oclyke-retired/Doppler_LED_Controller/Hardware/Production/v2.0.1/ordering_instructions.txt

panel size, 117x126mm
PCB thickness, 1.6mm
number of layers, 2
soldermask color, Unknown
silkscreen color, White
oz copper, 1oz
finish, HASL lead free
stencils, bottom
pcs per panel, 2
