oclyke-retired/Doppler_LED_Controller/Hardware/Configuration/Pinout/DopplerPinout_v2.0.0.PNG

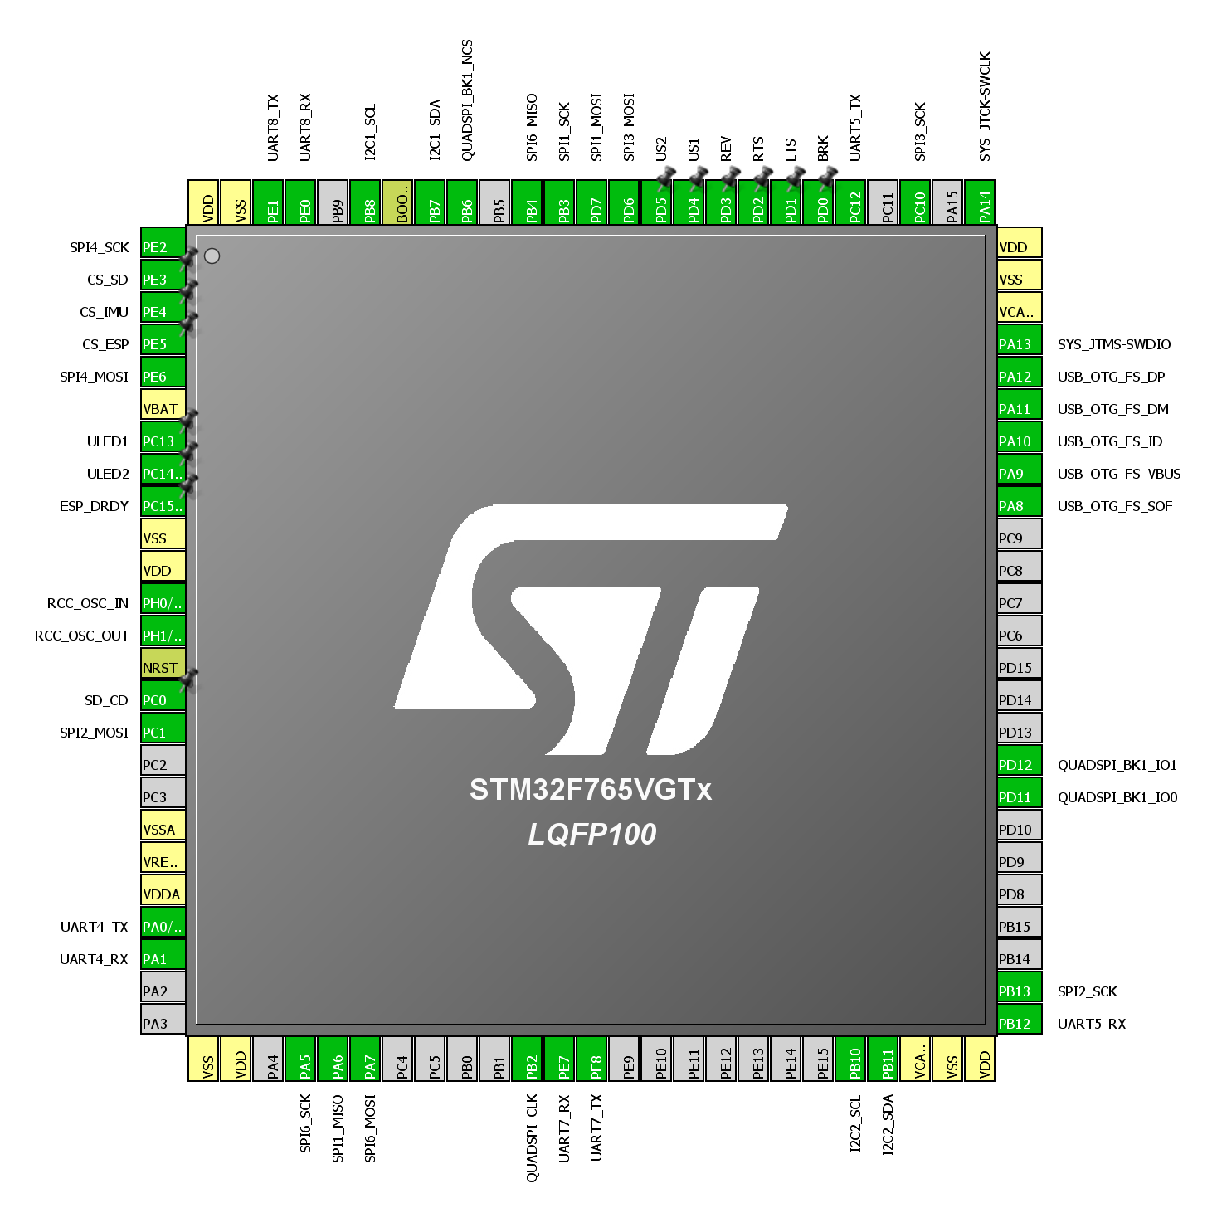
Hardware/Configuration/Pinout/DopplerPinout_v2.0.0.PNG
