oclyke-retired/Doppler_LED_Controller/Hardware/Doppler_LED_Controller.brd

## EAGLE design Hardware/Doppler_LED_Controller.brd (2018-11-28)

Schematic: Doppler_LED_Controller.sch

Parts:
C1, C3, C4, C6, C12, C13, C14, C15, C16, C20: 0.1uF; 0603
C2, C10, C11, C17, C18: 2.2uF; 0603
C5, C9: 10uF; 0603
C7, C8: 18pF; 0603
D1: ESPTX-GREEN; LED-0603
D2: ESP_STAT; APA102_2020_LONG
D3: ESPRX-YELLOW; LED-0603
D4: ULED1-BLUE; LED-0603
D5: ULED2-WHITE; LED-0603
D6: U7TX-GREEN; LED-0603
D8: U7RX-YELLOW; LED-0603
D10: 5.6V; SOD-323
D11: 3A/10V/280mV; SOD-323
D12: PWR-RED; LED-0603
F1: PPTC_6V500MA; 0805
FD1, FD2, FD3, FD4: FIDUCIAL1X2; FIDUCIAL-1X2
H1, H2, H3, H4: STAND-OFF
J1, J2: USB_MICRO-B_HALF_PTH_MILL; USB-MICROB-PTH-MILL
J3: CORTEX_DEBUG_PTH; 2X5-PTH-1.27MM
JP1: ALED1_VOUT_SEL; SMT-JUMPER_3_1-NC_TRACE_SILK
JP2: ALED2_VOUT_SEL; SMT-JUMPER_3_1-NC_TRACE_SILK
JP3: ALED3_VOUT_SEL; SMT-JUMPER_3_1-NC_TRACE_SILK
JP4: ALED4_VOUT_SEL; SMT-JUMPER_3_1-NC_TRACE_SILK
JP5, JP7: I2C1_VOUT_SEL; SMT-JUMPER_3_1-NC_TRACE_SILK
JP6: JUMPER-SMT_2_NO_SILK; SMT-JUMPER_2_NO_SILK
JP9: IMU_VSEL; SMT-JUMPER_3_1-NC_TRACE_SILK
JP10: MPU9250; SMT-JUMPER_2_NO_SILK
JP11: DEFUSE; SMT-JUMPER_2_NO_SILK
M1: EXT_SWTCH; 1X03_SMD_0.1IN
M2: EXT_SWTCH; 3_PIN_LOCK
M3: ALED1_LOCK; 3_PIN_LOCK
M4: ALED2_LOCK; 3_PIN_LOCK
M5: ALED3_LOCK; 3_PIN_LOCK
M6: ALED4_LOCK; 3_PIN_LOCK
M7: ALED1_SMD; 1X03_SMD_0.1IN
M8: ALED2_SMD; 1X03_SMD_0.1IN
M9: ALED3_SMD; 1X03_SMD_0.1IN
M10: ALED4_SMD; 1X03_SMD_0.1IN
M11: I2C1_LOCK; 4_PIN_LOCK
M13: U7_LOCK; 4_PIN_LOCK
M15: I2C1_SMD; 1X04_SMD_0.1IN
M17: U7_SMD; 1X04_SMD_0.1IN
M19: SIG_IN_LOCK; 4_PIN_LOCK
M20: SIG_IN_SMD; 1X04_SMD_0.1IN
M21: SD; SD_AMPHENOL_PUSH_PULL
M22: CONN_SMD_2; 1X02_SMD_0.1IN
M23: CONN_LOCK_2-5055670271; 2_PIN_LOCK
Q1: TRANS_NPN_DUAL-MBT3904DW1T1; SC70-6
Q2, Q3, Q4, Q5, Q6, Q7, Q8, Q9, Q10, Q12, Q14, Q16, Q18, Q19, Q20, Q21: AMP_MOSFET_NCH-2N7002K; SOT23-3
Q22, Q23: 4.3A/20V/54mΩ; SOT23-3
R1, R10: DNP; 0603
R3, R4, R6, R9, R16, R17, R18, R19, R20, R21, R22, R23, R24, R25, R26, R27, R28, R29, R30, R31, R32, R33, R34, R35, R36, R38, R39, R43, R47, R51, R57, R58, R59, R60, R61, R62, R63, R64, R65, R66, R67, R68: 10k; 0603
R7, R8, R11, R12, R53, R55, R69: 1k; 0603
R13, R14: 20; 0603
R37, R41, R45, R49: 2.2k; 0603
S1, S2, S3: US2; TACTILE_SWITCH_SMD_5.2MM
S4: STM_!RST; TACTILE_SWITCH_SMD_5.2MM
S5: US1; TACTILE_SWITCH_SMD_5.2MM
TP1: EDRDY; PAD.03X.04
TP3: ERX0; PAD.03X.04
TP4: ETX0; PAD.03X.04
TP5: E!RTS; PAD.03X.04
TP6: E!DTR; PAD.03X.04
TP7: EMOSI; PAD.03X.04
TP8: EMISO; PAD.03X.04
TP9: ESCLK; PAD.03X.04
TP10: ECS; PAD.03X.04
TP11: ESSI; PAD.03X.04
TP12: ESSCK; PAD.03X.04
TP13: E!RST; PAD.03X.04
TP17: VDDIO; PAD.03X.04
TP18: 1V8; PAD.03X.04
TP20: S1Si; PAD.03X.04
TP21: S1SO; PAD.03X.04
TP22: S1SCLk; PAD.03X.04
TP23: CSSD; PAD.03X.04
TP24: CSIMU; PAD.03X.04
TP25: SDCD; PAD.03X.04
TP29: CSIMUIO; PAD.03X.04
TP30: IMUINT; PAD.03X.04
TP31: IMUFS; PAD.03X.04
TP34: AL1D; PAD.03X.04
TP35: AL2D; PAD.03X.04
TP36: AL3D; PAD.03X.04
TP37: AL4D; PAD.03X.04
TP38: AL1V; PAD.03X.04
TP39: AL2V; PAD.03X.04
TP40: AL3V; PAD.03X.04
TP41: AL4V; PAD.03X.04
TP42: AL1C; PAD.03X.04
TP43: AL2C; PAD.03X.04
TP44: AL3C; PAD.03X.04
TP45: AL4C; PAD.03X.04
TP47: VRPP; PAD.03X.04
TP48: VOVP; PAD.03X.04
TP49: VUSB; PAD.03X.04
TP50: 5V; PAD.03X.04
TP51: 3V3; PAD.03X.04
TP52: GND; PAD.03X.04
TP53: IIC1SDA; PAD.03X.04
TP54: IIC1SCL; PAD.03X.04
TP57: U7TX; PAD.03X.04
TP58: U7RX; PAD.03X.04
TP62: STMR; PAD.03X.04
TP68: SWCLK; PAD.03X.04
TP69: BRK; PAD.03X.04
TP70: LTS; PAD.03X.04
TP71: RTS; PAD.03X.04
TP72: REV; PAD.03X.04
TP78: SWDIO; PAD.03X.04
U1: ESP-WROOM-32
U3: STM32F765VTG6; LQFP-100
U4: 1.8V; DDC5
U5: 9DoF IMU; QFN24-3X3
U6: TXB0108DQSR; UFDFN-20
U7: 3.3V; SOT23-5
U8: CH340C; SO016
U9: W25Q32FVSS; SOIC-8
U$98: REV_NUM
Y1: 24MHz; CRYSTAL-SMD-5X3.2-4PAD

Connections:
1.8V: JP9.3, TP18.P$1, U4.5 (VOUT)
3.3V: C2.1, C3.1, C4.1, C5.1, C6.1, C9.1, C14.1, C16.1, C18.1, C20.1, D1.A, D2.4VCC, D3.A, D4.A, D5.A, D6.A, D8.A, D12.A, J3.1 (VCC), JP1.1, JP2.1, JP3.1, JP4.1, JP5.3, JP6.1, JP7.3, JP9.1, M1.P$2 (2), M2.P$2 (2), M21.CD_SW2, M21.P$4 (VDD), Q2.1 (G), Q3.1 (G), Q4.1 (G), Q5.1 (G), Q6.1 (G), Q7.1 (G), Q8.1 (G), Q9.1 (G), Q10.1 (G), Q12.1 (G), Q14.1 (G), Q16.1 (G), Q18.1 (G), Q19.1 (G), Q20.1 (G), Q21.1 (G), R6.2, R9.2, R17.2, R18.2, R19.2, R21.2, R22.2, R23.2, R24.2, R29.2, R30.2, R31.2, R32.2, R37.2, R39.2, R45.2, R47.2, R57.2, R58.2, R59.2, R60.2, R65.2, R67.2, S3.3 (2), S3.4 (2), S5.3 (2), S5.4 (2), TP51.P$1, U1.2 (3V3), U3.P$6 (6.VBAT), U3.P$11 (11.VDD), U3.P$20 (20.VREF), U3.P$21 (21.VDDA), U3.P$27 (27.VDD), U3.P$50 (50.VDD), U3.P$75 (75.VDD), U3.P$100 (100.VDD), U4.1 (VIN), U4.3 (EN), U5.13 (VDD), U6.16 (VCCB), U7.5 (OUT), U8.4 (V3), U8.16 (VCC), U9.8 (VCC)
5V: C17.1, D11.C, JP1.3, JP2.3, JP3.3, JP4.3, JP5.1, JP7.1, Q23.2 (S), TP50.P$1, U7.1 (IN), U7.3 (EN)
ALED1_MOSI_VOUT: M3.P$1 (1), M7.P$1 (1), Q6.3 (D), R33.1
ALED1_SCLK_VOUT: M3.P$3 (3), M7.P$3 (3), Q2.3 (D), R25.1
ALED1_VOUT: JP1.2, R25.2, R33.2, TP38.P$1
ALED2_MOSI_VOUT: M4.P$1 (1), M8.P$1 (1), Q7.3 (D), R34.1
ALED2_SCLK_VOUT: M4.P$3 (3), M8.P$3 (3), Q3.3 (D), R26.1
ALED2_VOUT: JP2.2, R26.2, R34.2, TP39.P$1
ALED3_MOSI_VOUT: M5.P$1 (1), M9.P$1 (1), Q8.3 (D), R35.1
ALED3_SCLK_VOUT: M5.P$3 (3), M9.P$3 (3), Q4.3 (D), R27.1
ALED3_VOUT: JP3.2, R27.2, R35.2, TP40.P$1
ALED4_MOSI_VOUT: M6.P$1 (1), M10.P$1 (1), Q9.3 (D), R36.1
ALED4_SCLK_VOUT: M6.P$3 (3), M10.P$3 (3), Q5.3 (D), R28.1
ALED4_VOUT: JP4.2, R28.2, R36.2, TP41.P$1
BOOT0: JP6.2, R38.2, U3.P$94 (94.BOOT0)
BRK: Q18.2 (S), R57.1, TP69.P$1, U3.P$81 (81.PD0)
BRK_12V: M19.P$1 (1), M20.P$1 (1), Q18.3 (D), R61.1
CS_ESP: TP10.P$1, U1.29 (CS0_V/IO5), U3.P$4 (4.PE5)
CS_IMU: R67.1, TP24.P$1, U3.P$3 (3.PE4), U6.20 (B1)
CS_IMU_VDDIO: TP29.P$1, U5.22 (!CS), U6.1 (A1)
CS_SD: M21.P$2 (CD/DAT3), R65.1, TP23.P$1, U3.P$2 (2.PE3)
ESP_0: Q1.1 (E), R6.1, S1.1, S1.2 (1), U1.25 (IO0)
ESP_!DTR: Q1.6 (C), R3.2, TP6.P$1, U8.13 (!DTR)
ESP_!RESET: C1.1, Q1.3 (C), R9.1, S2.1, S2.2 (1), TP13.P$1, U1.3 (EN)
ESP_!RTS: Q1.4 (E), R4.2, TP5.P$1, U8.14 (!RTS)
ESP_DRDY: TP1.P$1, U1.24 (IO2), U3.P$9 (9.PC15)
ESP_RXI0: R8.1, TP3.P$1, U1.34 (RXD), U8.2 (TXO)
ESP_STAT_MOSI: D2.1DIN, TP11.P$1, U1.16 (MOSI_H/IO13)
ESP_STAT_SCLK: D2.2CIN, TP12.P$1, U1.13 (SCK_H/IO14)
ESP_TXO0: R7.1, TP4.P$1, U1.35 (TXD), U8.3 (RXI)
ESP_USB_DM: J1.D-, U8.6 (UD-)
ESP_USB_DP: J1.D+, U8.5 (UD+)
GND: C1.2, C2.2, C3.2, C4.2, C5.2, C6.2, C7.1, C8.1, C9.2, C10.2, C11.2, C12.1, C13.2, C14.2, C15.2, C16.2, C17.2, C18.2, C20.2, D2.3GND, D10.A, J1.GND, J2.GND, J3.3 (GND), J3.5 (GND), J3.9 (GNDDTCT), M3.P$2 (2), M4.P$2 (2), M5.P$2 (2), M6.P$2 (2), M7.P$2 (2), M8.P$2 (2), M9.P$2 (2), M10.P$2 (2), M11.P$4 (4), M13.P$4 (4), M15.P$4 (4), M17.P$4 (4), M21.P$6 (VSS1), M22.P$1 (1), M23.P$2 (1), Q22.1 (G), R1.1, R10.1, R16.1, R20.1, R38.1, R61.2, R62.2, R63.2, R64.2, R66.1, R68.1, R69.1, S1.3 (2), S1.4 (2), S2.3 (2), S2.4 (2), S4.3 (2), S4.4 (2), TP52.P$1, U1.1 (GND), U1.15 (GND), U1.38 (GND), U1.GND, U3.P$10 (10.VSS), U3.P$19 (19.VSSA), U3.P$26 (26.VSS), U3.P$49 (49.VSS), U3.P$74 (74.VSS), U3.P$99 (99.VSS), U4.2 (GND), U4.4 (GND), U5.18 (GND), U5.20 (RESV20), U6.15 (GND), U7.2 (GND), U8.1 (GND), U9.4 (GND), Y1.2 (GND), Y1.4 (GND)
I2C1_SCL: Q10.2 (S), R37.1, TP54.P$1, U3.P$95 (95.PB8)
I2C1_SCL_VOUT: M11.P$1 (1), M15.P$1 (1), Q10.3 (D), R41.1
I2C1_SDA: Q14.2 (S), R45.1, TP53.P$1, U3.P$93 (93.PB7)
I2C1_SDA_VOUT: M11.P$2 (2), M15.P$2 (2), Q14.3 (D), R49.1
I2C1_VOUT: JP5.2, M11.P$3 (3), M15.P$3 (3), R41.2, R49.2
I2C2_SCL: U3.P$46 (46.PB10)
I2C2_SDA: U3.P$47 (47.PB11)
IMU_FSYNC: TP31.P$1, U3.P$64 (64.PC7), U6.12 (B7)
IMU_FSYNC_VDDIO: U5.11 (FSYNC), U6.9 (A7)
IMU_INT: TP30.P$1, U3.P$63 (63.PC6), U6.11 (B8)
IMU_INT_VDDIO: U5.12 (INT), U6.10 (A8)
IMU_RESV1: JP10.1, U5.1 (RESV1)
IMU_VDDIO: C13.1, JP9.2, JP10.2, TP17.P$1, U5.8 (VDDIO), U6.5 (VCCA), U6.6 (OE)
LTS: Q19.2 (S), R58.1, TP70.P$1, U3.P$82 (82.PD1)
LTS_12V: M19.P$2 (2), M20.P$2 (2), Q19.3 (D), R62.1
unnamed: J2.SHIELD, J2.SHIELD2 (SHIELD), J2.SHIELD3 (SHIELD), J2.SHIELD4 (SHIELD), J2.SHIELD5 (SHIELD), J2.SHIELD6 (SHIELD), J2.SHIELD7 (SHIELD), J2.SHIELD8 (SHIELD), J2.SHIELD9 (SHIELD), J2.SHIELD10 (SHIELD), R10.2
unnamed: C11.1, U3.P$73 (73.VCAP2)
unnamed: J1.SHIELD, J1.SHIELD2 (SHIELD), J1.SHIELD3 (SHIELD), J1.SHIELD4 (SHIELD), J1.SHIELD5 (SHIELD), J1.SHIELD6 (SHIELD), J1.SHIELD7 (SHIELD), J1.SHIELD8 (SHIELD), J1.SHIELD9 (SHIELD), J1.SHIELD10 (SHIELD), R1.2
unnamed: C10.1, U3.P$48 (48.VCAP1)
unnamed: Q1.5 (B), R3.1
unnamed: Q1.2 (B), R4.1
unnamed: C15.1, U5.10 (REGOUT)
unnamed: D8.C, R55.2
unnamed: J3.2 (SWDIO/TMS), R13.1
unnamed: J3.4 (SWDCLK/TCK), R14.1
unnamed: D6.C, R53.2
unnamed: D1.C, R7.2
unnamed: D3.C, R8.2
unnamed: D12.C, R69.2
unnamed: D5.C, R12.2
unnamed: D4.C, R11.2
PH0: C7.2, U3.P$12 (12.PH0), Y1.3 (2)
PH1: C8.2, U3.P$13 (13.PH1), Y1.1
QSPI_BK1_IO0: Q9.2 (S), R32.1, TP37.P$1, U3.P$58 (58.PD11)
QSPI_BK1_IO1: U3.P$59 (59.PD12)
QSPI_BK1_IO2: U3.P$1 (1.PE2)
QSPI_BK1_IO3: U3.P$60 (60.PD13)
QSPI_BK1_NCS: U3.P$92 (92.PB6)
QSPI_BK2_IO0: U3.P$37 (37.PE7), U9.5 (SI(D0))
QSPI_BK2_IO1: U3.P$38 (38.PE8), U9.2 (SO(D1))
QSPI_BK2_IO2: U3.P$39 (39.PE9), U9.3 (!WP!(D2))
QSPI_BK2_IO3: U3.P$40 (40.PE10), U9.7 (!HOLD!(D3))
QSPI_BK2_NCS: U3.P$79 (79.PC11), U9.1 (!CS!)
QSPI_SCLK: Q5.2 (S), R24.1, TP45.P$1, U3.P$36 (36.PB2), U9.6 (SCK)
REV: Q21.2 (S), R60.1, TP72.P$1, U3.P$84 (84.PD3)
REV_12V: M19.P$4 (4), M20.P$4 (4), Q21.3 (D), R64.1
RTS: Q20.2 (S), R59.1, TP71.P$1, U3.P$83 (83.PD2)
RTS_12V: M19.P$3 (3), M20.P$3 (3), Q20.3 (D), R63.1
SD_CD: M21.CD_SW1, R66.2, TP25.P$1, U3.P$15 (15.PC0)
SPI1_MISO: M21.P$7 (DAT0), TP21.P$1, U3.P$30 (30.PA6), U6.13 (B6)
SPI1_MISO_VDDIO: U5.9 (AD0/SDO), U6.8 (A6)
SPI1_MOSI: M21.P$3 (CMD), TP20.P$1, U3.P$88 (88.PD7), U6.18 (B3)
SPI1_MOSI_VDDIO: U5.24 (SDA/SDI), U6.3 (A3)
SPI1_SCLK: M21.P$5 (CLK), TP22.P$1, U3.P$89 (89.PB3), U6.19 (B2)
SPI1_SCLK_VDDIO: U5.23 (SCL/SCLK), U6.2 (A2)
SPI2_MOSI: Q6.2 (S), R29.1, TP34.P$1, U3.P$16 (16.PC1)
SPI2_SCLK: Q2.2 (S), R21.1, TP42.P$1, U3.P$52 (52.PB13)
SPI3_MOSI: Q7.2 (S), R30.1, TP35.P$1, U3.P$87 (87.PD6)
SPI3_SCLK: Q3.2 (S), R22.1, TP43.P$1, U3.P$78 (78.PC10)
SPI4_MOSI: Q8.2 (S), R31.1, TP36.P$1, U3.P$5 (5.PE6)
SPI4_SCLK: Q4.2 (S), R23.1, TP44.P$1, U3.P$42 (42.PE12)
SPI6_MISO: TP8.P$1, U1.31 (MISO_V/IO19), U3.P$90 (90.PB4)
SPI6_MOSI: TP7.P$1, U1.37 (MOSI_V/IO23), U3.P$31 (31.PA7)
SPI6_SCLK: TP9.P$1, U1.30 (SCK_V/IO18), U3.P$29 (29.PA5)
STM_!RESET: C12.2, J3.10 (!RESET), R19.1, S4.1, S4.2 (1), TP62.P$1, U3.P$14 (14.NRST)
STM_USB_DM: J2.D-, U3.P$70 (70.PA11)
STM_USB_DP: J2.D+, U3.P$71 (71.PA12)
SWCLK: R14.2, R17.1, TP68.P$1, U3.P$76 (76.PA14)
SWDIO: R13.2, R18.1, TP78.P$1, U3.P$72 (72.PA13)
UART4_RX: U1.28 (IO17), U3.P$23 (23.PA1)
UART4_TX: U1.27 (IO16), U3.P$22 (22.PA0)
UART5_RX: U3.P$51 (51.PB12)
UART5_TX: U3.P$80 (80.PC12)
UART8_RX: U3.P$97 (97.PE0)
UART8_TX: U3.P$98 (98.PE1)
ULED1: R11.1, U3.P$7 (7.PC13)
ULED2: R12.1, U3.P$8 (8.PC14)
US1: M1.P$3 (3), M2.P$3 (3), R20.2, S5.1, S5.2 (1), U3.P$85 (85.PD4)
US2: M1.P$1 (1), M2.P$1 (1), R16.2, S3.1, S3.2 (1), U3.P$86 (86.PD5)
USART1_RX: Q16.2 (S), R47.1, R55.1, TP58.P$1, U3.P$54 (54.PB15)
USART1_RX_VOUT: M13.P$1 (1), M17.P$1 (1), Q16.3 (D), R51.1
USART1_TX: Q12.2 (S), R39.1, R53.1, TP57.P$1, U3.P$53 (53.PB14)
USART1_TX_VOUT: M13.P$2 (2), M17.P$2 (2), Q12.3 (D), R43.1
USART1_VOUT: JP7.2, M13.P$3 (3), M17.P$3 (3), R43.2, R51.2
USB_OTG_FS_ID: J2.ID, U3.P$69 (69.PA10)
USB_OTG_FS_SOF: U3.P$67 (67.PA8)
VOVP: D10.C, F1.2, JP11.2, Q23.3 (D), TP48.P$1
VRAW: M22.P$2 (2), M23.P$3 (2), Q22.3 (D)
VRPP: F1.1, JP11.1, Q22.2 (S), TP47.P$1
V_USB: D11.A, J1.VBUS, J2.VBUS, Q23.1 (G), R68.2, TP49.P$1, U3.P$68 (68.PA9)

Notes on the sheet:
Completed peripherals
SPI1
SPI2 (TX only)
SPI3 (TX only)
SPI4 (TX only)
QSPI (BK1)
SPI6
UART4
UART5
UART7
UART8
I2C1
I2C2
Connect jumper if using MPU9250
ICM 20948 : 1.8V MPU 9250 : 3.3V
Max input: 6V
STM32
ESP32
SPI1 Devices
Power Supply
Output Conditioning
Input Conditioning

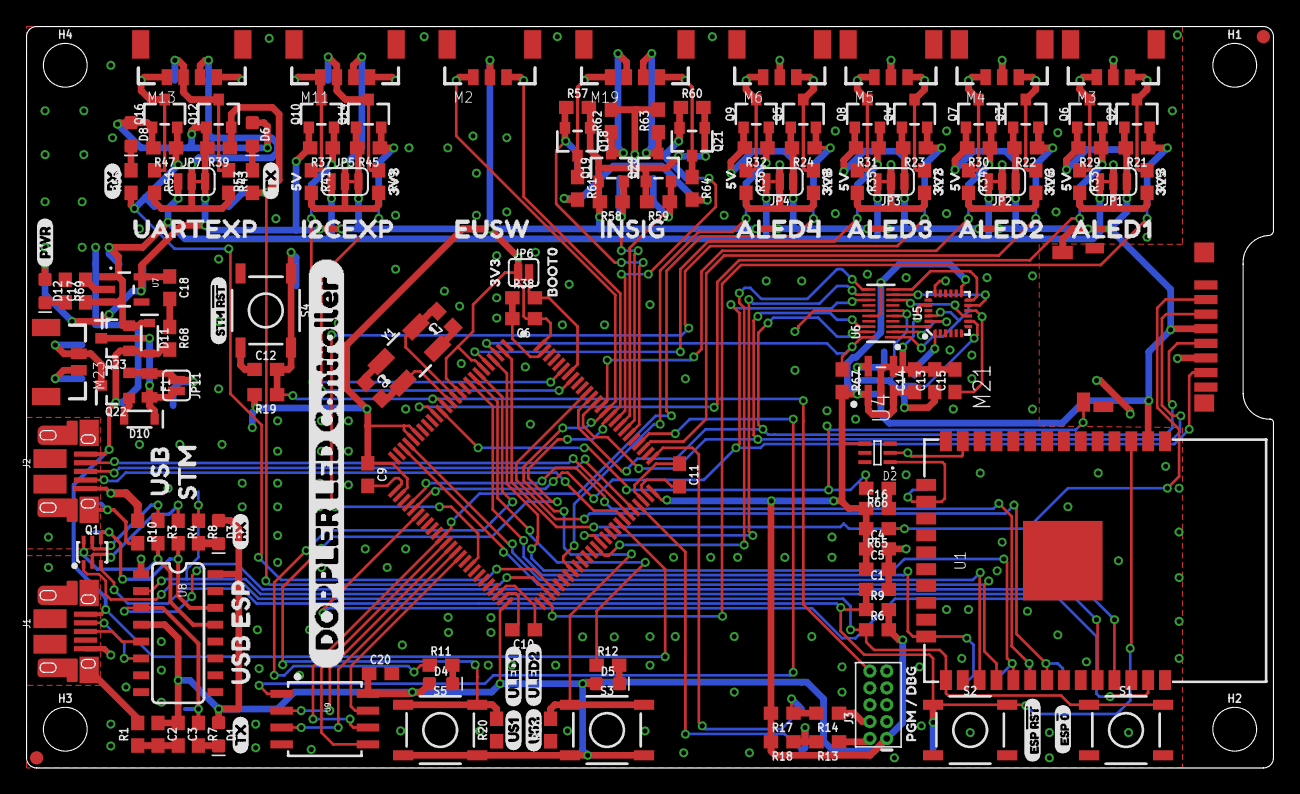
[picture p3: board Doppler_LED_Controller.brd from above]

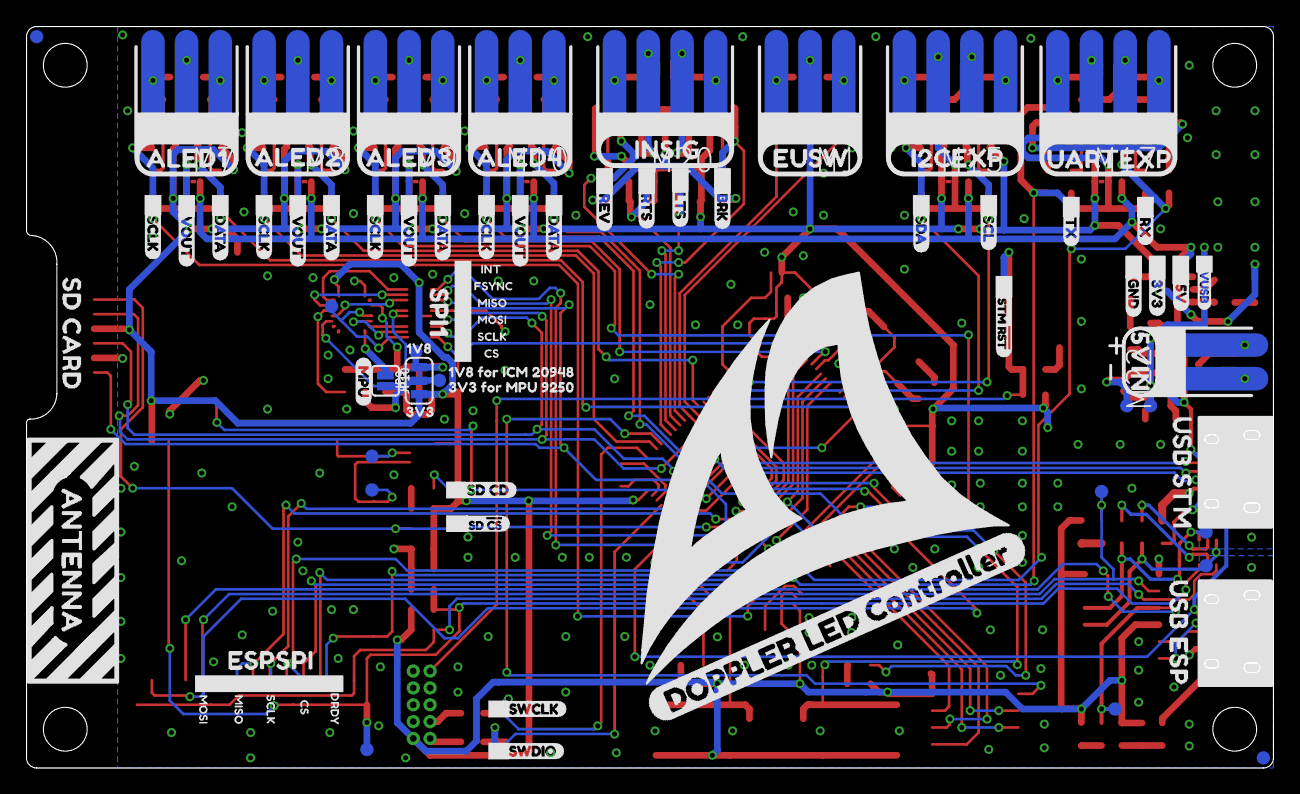
[picture p4: board Doppler_LED_Controller.brd from below]

Board: 2 copper layers, 94.0 x 55.9 mm, 311 parts (127 on the bottom side), 113 nets.

Other parts of the board:
U$1, U$74: ALED10
U$2, U$75: ALED21
U$3: ALED43
U$4, U$76: ALED33
U$5, U$78: INSIG4
U$6, U$79: UARTEXP7
U$7, U$80: I2CEXP6
U$8, U$81: EUSW5
U$9, U$10, U$11, U$12: SCLK1
U$13, U$14, U$15, U$16: VOUT2
U$17, U$18, U$19, U$20: DATA0
U$21: RTS4
U$22: LTS3
U$23: BRK5
U$24: REV6
U$25: SCL8
U$26: SDA7
U$27, U$63, U$66: TX9
U$28, U$64, U$67: RX10
U$29: 5VIN8
U$30: VUSB15
U$31: 5V14
U$32: 3V313
U$33: GND12
U$34: SWCLK16
U$35: SWDIO15
U$36, U$48: SCLK20
U$37, U$49: CS21
U$38, U$47: MISO18
U$39, U$46: MOSI17
U$40: DRDY19
U$41: ESPSPI9
U$42: ANTENNA10
U$43: SD_CARD11
U$44, U$71: USB_ESP12
U$45: USB_STM13
U$50: FSYNC23
U$51: INT22
U$52: STM_#RST26
U$53: SD_#CS24
U$54: SD_CD27
U$55, U$68: DOPPLER_LED_CONTROLLER0
U$56: ULED23
U$57: ULED12
U$58: US10
U$59: US21
U$60: ESP_#RST5
U$61: ESP_#06
U$62: PGM_#_DBG7
U$65: PWR8
U$69: STM_#RST24
U$72, U$82, U$83, U$84, U$85, U$86: 3V310
U$73: BOOT09
U$77: ALED42
U$87, U$88, U$89, U$90, U$91: 5V11
U$92: SPI116
U$93: 3V39
U$94: 1V817
U$95: 1V8_FOR_ICM_2094818
U$96: 3V3_FOR_MPU_925019
U$97: MPU20
U$99: USB0
U$100: STM1
