oclyke-retired/Doppler_LED_Controller/Hardware/Production/v2.0.1/Doppler_LED_Controller-Panel.brd

## EAGLE design Hardware/Production/v2.0.1/Doppler_LED_Controller-Panel.brd (2018-11-28)

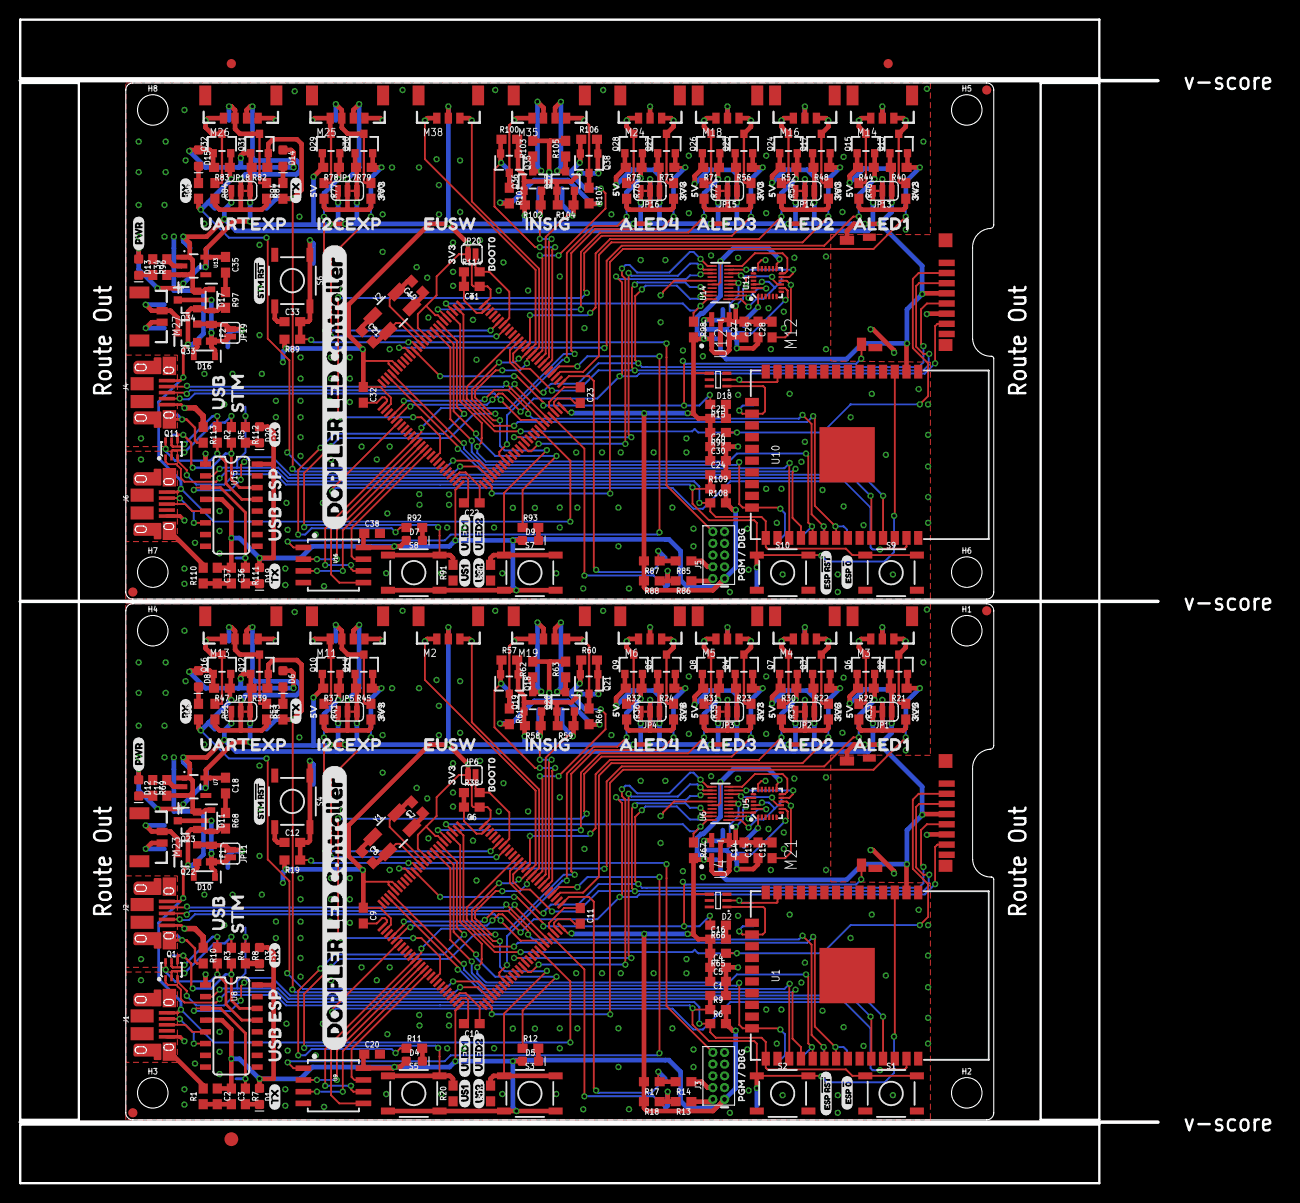
[picture p5: board Doppler_LED_Controller-Panel.brd from above]

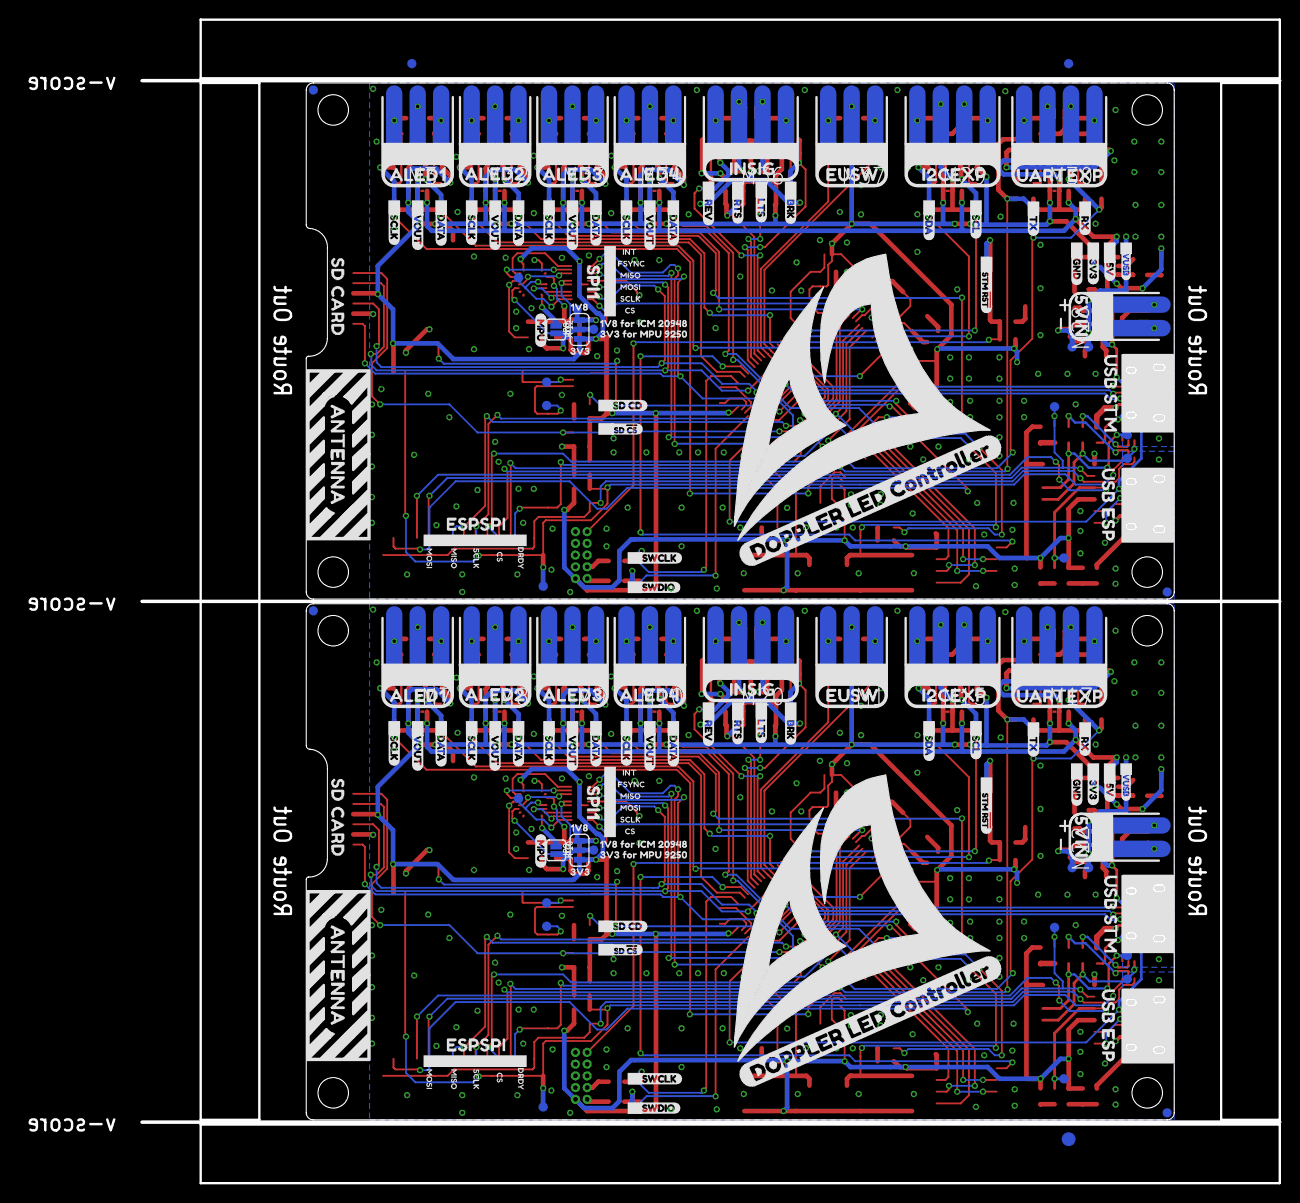
[picture p6: board Doppler_LED_Controller-Panel.brd from below]

Board: 2 copper layers, 123.2 x 126.0 mm, 628 parts (257 on the bottom side), 226 nets.

Parts:
C1, C3, C4, C6, C12, C13, C14, C15, C16, C20, C24, C25, C26, C27, C28, C29, C31, C33, C36, C38: 0.1uF; 0603
C2, C10, C11, C17, C18, C22, C23, C34, C35, C37: 2.2uF; 0603
C5, C9, C30, C32: 10uF; 0603
C7, C8, C19, C21: 18pF; 0603
D1, D19: ESPTX-GREEN; LED-0603
D2, D18: ESP_STAT; APA102_2020_LONG
D3, D20: ESPRX-YELLOW; LED-0603
D4, D7: ULED1-BLUE; LED-0603
D5, D9: ULED2-WHITE; LED-0603
D6, D14: U7TX-GREEN; LED-0603
D8, D15: U7RX-YELLOW; LED-0603
D10, D16: 5.6V; SOD-323
D11, D17: 3A/10V/280mV; SOD-323
D12, D13: PWR-RED; LED-0603
E$1, E$2, E$3, E$4: FIDUCIAL-1X2
E$5, E$6: FIDUCIAL-1.5X3
F1, F2: PPTC_6V500MA; 0805
FD1, FD2, FD3, FD4, FD5, FD6, FD7, FD8: FIDUCIAL1X2; FIDUCIAL-1X2
H1, H2, H3, H4, H5, H6, H7, H8: STAND-OFF
J1, J2, J4, J6: USB-MICROB-PTH-MILL
J3, J5: CORTEX_DEBUG_PTH; 2X5-PTH-1.27MM
JP1, JP13: ALED1_VOUT_SEL; SMT-JUMPER_3_1-NC_TRACE_SILK
JP2, JP14: ALED2_VOUT_SEL; SMT-JUMPER_3_1-NC_TRACE_SILK
JP3, JP15: ALED3_VOUT_SEL; SMT-JUMPER_3_1-NC_TRACE_SILK
JP4, JP16: ALED4_VOUT_SEL; SMT-JUMPER_3_1-NC_TRACE_SILK
JP5, JP7, JP17, JP18: I2C1_VOUT_SEL; SMT-JUMPER_3_1-NC_TRACE_SILK
JP6, JP20: JUMPER-SMT_2_NO_SILK; SMT-JUMPER_2_NO_SILK
JP8, JP9: IMU_VSEL; SMT-JUMPER_3_1-NC_TRACE_SILK
JP10, JP12: MPU9250; SMT-JUMPER_2_NO_SILK
JP11, JP19: DEFUSE; SMT-JUMPER_2_NO_SILK
M1, M37: EXT_SWTCH; 1X03_SMD_0.1IN
M2, M38: EXT_SWTCH; 3_PIN_LOCK
M3, M14: ALED1_LOCK; 3_PIN_LOCK
M4, M16: ALED2_LOCK; 3_PIN_LOCK
M5, M18: ALED3_LOCK; 3_PIN_LOCK
M6, M24: ALED4_LOCK; 3_PIN_LOCK
M7, M31: ALED1_SMD; 1X03_SMD_0.1IN
M8, M32: ALED2_SMD; 1X03_SMD_0.1IN
M9, M33: ALED3_SMD; 1X03_SMD_0.1IN
M10, M34: ALED4_SMD; 1X03_SMD_0.1IN
M11, M25: I2C1_LOCK; 4_PIN_LOCK
M12, M21: SD; SD_AMPHENOL_PUSH_PULL
M13, M26: U7_LOCK; 4_PIN_LOCK
M15, M29: I2C1_SMD; 1X04_SMD_0.1IN
M17, M30: U7_SMD; 1X04_SMD_0.1IN
M19, M35: SIG_IN_LOCK; 4_PIN_LOCK
M20, M36: SIG_IN_SMD; 1X04_SMD_0.1IN
M22, M28: 1X02_SMD_0.1IN
M23, M27: 2_PIN_LOCK
Q1, Q11: SC70-6
Q2, Q3, Q4, Q5, Q6, Q7, Q8, Q9, Q10, Q12, Q13, Q14, Q15, Q16, Q17, Q18, Q19, Q20, Q21, Q24, Q25, Q26, Q27, Q28, Q29, Q30, Q31, Q32, Q35, Q36, Q37, Q38: SOT23-3
Q22, Q23, Q33, Q34: 4.3A/20V/54mΩ; SOT23-3
R1, R10, R110, R113: DNP; 0603
R2, R3, R4, R5, R6, R9, R15, R16, R17, R18, R19, R20, R21, R22, R23, R24, R25, R26, R27, R28, R29, R30, R31, R32, R33, R34, R35, R36, R38, R39, R40, R42, R43, R44, R46, R47, R48, R50, R51, R52, R54, R56, R57, R58, R59, R60, R61, R62, R63, R64, R65, R66, R67, R68, R70, R71, R72, R73, R74, R75, R76, R81, R82, R83, R84, R87, R88, R89, R90, R91, R97, R98, R99, R100, R101, R102, R103, R104, R105, R106, R107, R108, R109, R114: 10k; 0603
R7, R8, R11, R12, R53, R55, R69, R92, R93, R94, R95, R96, R111, R112: 1k; 0603
R13, R14, R85, R86: 20; 0603
R37, R41, R45, R49, R77, R78, R79, R80: 2.2k; 0603
S1, S2, S3, S7, S9, S10: US2; TACTILE_SWITCH_SMD_5.2MM
S4, S6: STM_!RST; TACTILE_SWITCH_SMD_5.2MM
S5, S8: US1; TACTILE_SWITCH_SMD_5.2MM
TP1, TP104: EDRDY; PAD.03X.04
TP2, TP3: ERX0; PAD.03X.04
TP4, TP14: ETX0; PAD.03X.04
TP5, TP15: E!RTS; PAD.03X.04
TP6, TP16: E!DTR; PAD.03X.04
TP7, TP19: EMOSI; PAD.03X.04
TP8, TP26: EMISO; PAD.03X.04
TP9, TP27: ESCLK; PAD.03X.04
TP10, TP28: ECS; PAD.03X.04
TP11, TP32: ESSI; PAD.03X.04
TP12, TP33: ESSCK; PAD.03X.04
TP13, TP46: E!RST; PAD.03X.04
TP17, TP63: VDDIO; PAD.03X.04
TP18, TP73: 1V8; PAD.03X.04
TP20, TP55: S1Si; PAD.03X.04
TP21, TP56: S1SO; PAD.03X.04
TP22, TP59: S1SCLk; PAD.03X.04
TP23, TP60: CSSD; PAD.03X.04
TP24, TP61: CSIMU; PAD.03X.04
TP25, TP64: SDCD; PAD.03X.04
TP29, TP65: CSIMUIO; PAD.03X.04
TP30, TP66: IMUINT; PAD.03X.04
TP31, TP67: IMUFS; PAD.03X.04
TP34, TP81: AL1D; PAD.03X.04
TP35, TP84: AL2D; PAD.03X.04
TP36, TP87: AL3D; PAD.03X.04
TP37, TP90: AL4D; PAD.03X.04
TP38, TP82: AL1V; PAD.03X.04
TP39, TP85: AL2V; PAD.03X.04
TP40, TP88: AL3V; PAD.03X.04
TP41, TP91: AL4V; PAD.03X.04
TP42, TP83: AL1C; PAD.03X.04
TP43, TP86: AL2C; PAD.03X.04
TP44, TP89: AL3C; PAD.03X.04
TP45, TP92: AL4C; PAD.03X.04
TP47, TP74: VRPP; PAD.03X.04
TP48, TP75: VOVP; PAD.03X.04
TP49, TP76: VUSB; PAD.03X.04
TP50, TP77: 5V; PAD.03X.04
TP51, TP79: 3V3; PAD.03X.04
TP52, TP80: GND; PAD.03X.04
TP53, TP97: IIC1SDA; PAD.03X.04
TP54, TP98: IIC1SCL; PAD.03X.04
TP57, TP99: U7TX; PAD.03X.04
TP58, TP100: U7RX; PAD.03X.04
TP62, TP101: STMR; PAD.03X.04
TP68, TP102: SWCLK; PAD.03X.04
TP69, TP93: BRK; PAD.03X.04
TP70, TP94: LTS; PAD.03X.04
TP71, TP95: RTS; PAD.03X.04
TP72, TP96: REV; PAD.03X.04
TP78, TP103: SWDIO; PAD.03X.04
U1, U10: ESP-WROOM-32
U2, U3: LQFP-100
U4, U12: 1.8V; DDC5
U5, U11: 9DoF IMU; QFN24-3X3
U6, U14: TXB0108DQSR; UFDFN-20
U7, U13: 3.3V; SOT23-5
U8, U15: CH340C; SO016
U9, U16: W25Q32FVSS; SOIC-8
U$1, U$70, U$74, U$168: ALED10
U$2, U$75, U$101, U$169: ALED21
U$3, U$102: ALED43
U$4, U$76, U$103, U$170: ALED33
U$5, U$78, U$104, U$172: INSIG4
U$6, U$79, U$105, U$173: UARTEXP7
U$7, U$80, U$106, U$174: I2CEXP6
U$8, U$81, U$107, U$175: EUSW5
U$9, U$10, U$11, U$12, U$108, U$109, U$110, U$111: SCLK1
U$13, U$14, U$15, U$16, U$112, U$113, U$114, U$115: VOUT2
U$17, U$18, U$19, U$20, U$116, U$117, U$118, U$119: DATA0
U$21, U$120: RTS4
U$22, U$121: LTS3
U$23, U$122: BRK5
U$24, U$123: REV6
U$25, U$124: SCL8
U$26, U$125: SDA7
U$27, U$63, U$66, U$126, U$158, U$161: TX9
U$28, U$64, U$67, U$127, U$159, U$162: RX10
U$29, U$128: 5VIN8
U$30, U$186: VUSB15
U$31, U$187: 5V14
U$32, U$188: 3V313
U$33, U$189: GND12
U$34, U$129: SWCLK16
U$35, U$130: SWDIO15
U$36, U$48, U$131, U$143: SCLK20
U$37, U$49, U$132, U$144: CS21
U$38, U$47, U$133, U$142: MISO18
U$39, U$46, U$134, U$141: MOSI17
U$40, U$135: DRDY19
U$41, U$136: ESPSPI9
U$42, U$137: ANTENNA10
U$43, U$138: SD_CARD11
U$44, U$71, U$139, U$165: USB_ESP12
U$45, U$140: USB_STM13
U$50, U$145: FSYNC23
U$51, U$146: INT22
U$52, U$147: STM_#RST26
U$53, U$148: SD_#CS24
U$54, U$149: SD_CD27
U$55, U$68, U$150, U$163: DOPPLER_LED_CONTROLLER0
U$56, U$151: ULED23
U$57, U$152: ULED12
U$58, U$153: US10
U$59, U$154: US21
U$60, U$155: ESP_#RST5
U$61, U$156: ESP_#06
U$62, U$157: PGM_#_DBG7
U$65, U$160: PWR8
U$69, U$164: STM_#RST24
U$72, U$82, U$83, U$84, U$85, U$86, U$166, U$176, U$177, U$178, U$179, U$180: 3V310
U$73, U$167: BOOT09
U$77, U$171: ALED42
U$87, U$88, U$89, U$90, U$91, U$181, U$182, U$183, U$184, U$185: 5V11
U$92, U$190: SPI116
U$93, U$191: 3V39
U$94, U$192: 1V817
U$95, U$193: 1V8_FOR_ICM_2094818
U$96, U$194: 3V3_FOR_MPU_925019
U$97, U$195: MPU20
U$98, U$196: REV_NUM
U$99, U$197: USB0
U$100, U$198: STM1
Y1, Y2: 24MHz; CRYSTAL-SMD-5X3.2-4PAD

Connections:
1.8V: JP9.3, TP18.P$1, U4.5
1.8V1: JP8.3, TP73.P$1, U12.5
3.3V: C2.1, C3.1, C4.1, C5.1, C6.1, C9.1, C14.1, C16.1, C18.1, C20.1, D1.A, D2.4VCC, D3.A, D4.A, D5.A, D6.A, D8.A, D12.A, J3.1, JP1.1, JP2.1, JP3.1, JP4.1, JP5.3, JP6.1, JP7.3, JP9.1, M1.P$2, M2.P$2, M21.CD_SW2, M21.P$4, Q2.1, Q3.1, Q4.1, Q5.1, Q6.1, Q7.1, Q8.1, Q9.1, Q10.1, Q12.1, Q14.1, Q16.1, Q18.1, Q19.1, Q20.1, Q21.1, R6.2, R9.2, R17.2, R18.2, R19.2, R21.2, R22.2, R23.2, R24.2, R29.2, R30.2, R31.2, R32.2, R37.2, R39.2, R45.2, R47.2, R57.2, R58.2, R59.2, R60.2, R65.2, R67.2, S3.3, S3.4, S5.3, S5.4, TP51.P$1, U1.2, U3.P$6, U3.P$11, U3.P$20, U3.P$21, U3.P$27, U3.P$50, U3.P$75, U3.P$100, U4.1, U4.3, U5.13, U6.16, U7.5, U8.4, U8.16, U9.8
3.3V1: C25.1, C26.1, C27.1, C30.1, C31.1, C32.1, C35.1, C36.1, C37.1, C38.1, D7.A, D9.A, D13.A, D14.A, D15.A, D18.4VCC, D19.A, D20.A, J5.1, JP8.1, JP13.1, JP14.1, JP15.1, JP16.1, JP17.3, JP18.3, JP20.1, M12.CD_SW2, M12.P$4, M37.P$2, M38.P$2, Q13.1, Q15.1, Q17.1, Q24.1, Q25.1, Q26.1, Q27.1, Q28.1, Q29.1, Q30.1, Q31.1, Q32.1, Q35.1, Q36.1, Q37.1, Q38.1, R40.2, R44.2, R48.2, R52.2, R56.2, R71.2, R73.2, R75.2, R78.2, R79.2, R82.2, R83.2, R87.2, R88.2, R89.2, R98.2, R99.2, R100.2, R102.2, R104.2, R106.2, R108.2, R109.2, S7.3, S7.4, S8.3, S8.4, TP79.P$1, U2.P$6, U2.P$11, U2.P$20, U2.P$21, U2.P$27, U2.P$50, U2.P$75, U2.P$100, U10.2, U11.13, U12.1, U12.3, U13.5, U14.16, U15.4, U15.16, U16.8
5V: C17.1, D11.C, JP1.3, JP2.3, JP3.3, JP4.3, JP5.1, JP7.1, Q23.2, TP50.P$1, U7.1, U7.3
5V1: C34.1, D17.C, JP13.3, JP14.3, JP15.3, JP16.3, JP17.1, JP18.1, Q34.2, TP77.P$1, U13.1, U13.3
ALED1_MOSI_VOUT: M3.P$1, M7.P$1, Q6.3, R33.1
ALED1_MOSI_VOUT1: M14.P$1, M31.P$1, Q15.3, R46.1
ALED1_SCLK_VOUT: M3.P$3, M7.P$3, Q2.3, R25.1
ALED1_SCLK_VOUT1: M14.P$3, M31.P$3, Q13.3, R42.1
ALED1_VOUT: JP1.2, R25.2, R33.2, TP38.P$1
ALED1_VOUT1: JP13.2, R42.2, R46.2, TP82.P$1
ALED2_MOSI_VOUT: M4.P$1, M8.P$1, Q7.3, R34.1
ALED2_MOSI_VOUT1: M16.P$1, M32.P$1, Q24.3, R54.1
ALED2_SCLK_VOUT: M4.P$3, M8.P$3, Q3.3, R26.1
ALED2_SCLK_VOUT1: M16.P$3, M32.P$3, Q17.3, R50.1
ALED2_VOUT: JP2.2, R26.2, R34.2, TP39.P$1
ALED2_VOUT1: JP14.2, R50.2, R54.2, TP85.P$1
ALED3_MOSI_VOUT: M5.P$1, M9.P$1, Q8.3, R35.1
ALED3_MOSI_VOUT1: M18.P$1, M33.P$1, Q26.3, R72.1
ALED3_SCLK_VOUT: M5.P$3, M9.P$3, Q4.3, R27.1
ALED3_SCLK_VOUT1: M18.P$3, M33.P$3, Q25.3, R70.1
ALED3_VOUT: JP3.2, R27.2, R35.2, TP40.P$1
ALED3_VOUT1: JP15.2, R70.2, R72.2, TP88.P$1
ALED4_MOSI_VOUT: M6.P$1, M10.P$1, Q9.3, R36.1
ALED4_MOSI_VOUT1: M24.P$1, M34.P$1, Q28.3, R76.1
ALED4_SCLK_VOUT: M6.P$3, M10.P$3, Q5.3, R28.1
ALED4_SCLK_VOUT1: M24.P$3, M34.P$3, Q27.3, R74.1
ALED4_VOUT: JP4.2, R28.2, R36.2, TP41.P$1
ALED4_VOUT1: JP16.2, R74.2, R76.2, TP91.P$1
BOOT0: JP6.2, R38.2, U3.P$94
BOOT1: JP20.2, R114.2, U2.P$94
BRK: Q18.2, R57.1, TP69.P$1, U3.P$81
BRK1: Q35.2, R100.1, TP93.P$1, U2.P$81
BRK_12V: M19.P$1, M20.P$1, Q18.3, R61.1
BRK_12V1: M35.P$1, M36.P$1, Q35.3, R101.1
CS_ESP: TP10.P$1, U1.29, U3.P$4
CS_ESP1: TP28.P$1, U2.P$4, U10.29
CS_IMU: R67.1, TP24.P$1, U3.P$3, U6.20
CS_IMU1: R98.1, TP61.P$1, U2.P$3, U14.20
CS_IMU_VDDIO: TP29.P$1, U5.22, U6.1
CS_IMU_VDDIO1: TP65.P$1, U11.22, U14.1
CS_SD: M21.P$2, R65.1, TP23.P$1, U3.P$2
CS_SD1: M12.P$2, R99.1, TP60.P$1, U2.P$2
ESP_0: Q1.1, R6.1, S1.1, S1.2, U1.25
ESP_1: Q11.1, R108.1, S9.1, S9.2, U10.25
ESP_!DTR: Q1.6, R3.2, TP6.P$1, U8.13
ESP_!DTR1: Q11.6, R2.2, TP16.P$1, U15.13
ESP_!RESET: C1.1, Q1.3, R9.1, S2.1, S2.2, TP13.P$1, U1.3
ESP_!RESET1: C24.1, Q11.3, R109.1, S10.1, S10.2, TP46.P$1, U10.3
ESP_!RTS: Q1.4, R4.2, TP5.P$1, U8.14
ESP_!RTS1: Q11.4, R5.2, TP15.P$1, U15.14
ESP_DRDY: TP1.P$1, U1.24, U3.P$9
ESP_DRDY1: TP104.P$1, U2.P$9, U10.24
ESP_RXI0: R8.1, TP3.P$1, U1.34, U8.2
ESP_RXI1: R112.1, TP2.P$1, U10.34, U15.2
ESP_STAT_MOSI: D2.1DIN, TP11.P$1, U1.16
ESP_STAT_MOSI1: D18.1DIN, TP32.P$1, U10.16
ESP_STAT_SCLK: D2.2CIN, TP12.P$1, U1.13
ESP_STAT_SCLK1: D18.2CIN, TP33.P$1, U10.13
ESP_TXO0: R7.1, TP4.P$1, U1.35, U8.3
ESP_TXO1: R111.1, TP14.P$1, U10.35, U15.3
ESP_USB_DM: J1.D-, U8.6
ESP_USB_DM1: J6.D-, U15.6
ESP_USB_DP: J1.D+, U8.5
ESP_USB_DP1: J6.D+, U15.5
GND: C1.2, C2.2, C3.2, C4.2, C5.2, C6.2, C7.1, C8.1, C9.2, C10.2, C11.2, C12.1, C13.2, C14.2, C15.2, C16.2, C17.2, C18.2, C20.2, D2.3GND, D10.A, J1.GND, J2.GND, J3.3, J3.5, J3.9, M3.P$2, M4.P$2, M5.P$2, M6.P$2, M7.P$2, M8.P$2, M9.P$2, M10.P$2, M11.P$4, M13.P$4, M15.P$4, M17.P$4, M21.P$6, M22.P$1, M23.P$2, Q22.1, R1.1, R10.1, R16.1, R20.1, R38.1, R61.2, R62.2, R63.2, R64.2, R66.1, R68.1, R69.1, S1.3, S1.4, S2.3, S2.4, S4.3, S4.4, TP52.P$1, U1.1, U1.15, U1.38, U1.GND, U3.P$10, U3.P$19, U3.P$26, U3.P$49, U3.P$74, U3.P$99, U4.2, U4.4, U5.18, U5.20, U6.15, U7.2, U8.1, U9.4, Y1.2, Y1.4
GND1: C19.1, C21.1, C22.2, C23.2, C24.2, C25.2, C26.2, C27.2, C28.2, C29.2, C30.2, C31.2, C32.2, C33.1, C34.2, C35.2, C36.2, C37.2, C38.2, D16.A, D18.3GND, J4.GND, J5.3, J5.5, J5.9, J6.GND, M12.P$6, M14.P$2, M16.P$2, M18.P$2, M24.P$2, M25.P$4, M26.P$4, M27.P$2, M28.P$1, M29.P$4, M30.P$4, M31.P$2, M32.P$2, M33.P$2, M34.P$2, Q33.1, R15.1, R90.1, R91.1, R96.1, R97.1, R101.2, R103.2, R105.2, R107.2, R110.1, R113.1, R114.1, S6.3, S6.4, S9.3, S9.4, S10.3, S10.4, TP80.P$1, U2.P$10, U2.P$19, U2.P$26, U2.P$49, U2.P$74, U2.P$99, U10.1, U10.15, U10.38, U10.GND, U11.18, U11.20, U12.2, U12.4, U13.2, U14.15, U15.1, U16.4, Y2.2, Y2.4
I2C1_SCL: Q10.2, R37.1, TP54.P$1, U3.P$95
I2C1_SCL1: Q29.2, R78.1, TP98.P$1, U2.P$95
I2C1_SCL_VOUT: M11.P$1, M15.P$1, Q10.3, R41.1
I2C1_SCL_VOUT1: M25.P$1, M29.P$1, Q29.3, R77.1
I2C1_SDA: Q14.2, R45.1, TP53.P$1, U3.P$93
I2C1_SDA1: Q30.2, R79.1, TP97.P$1, U2.P$93
I2C1_SDA_VOUT: M11.P$2, M15.P$2, Q14.3, R49.1
I2C1_SDA_VOUT1: M25.P$2, M29.P$2, Q30.3, R80.1
I2C1_VOUT: JP5.2, M11.P$3, M15.P$3, R41.2, R49.2
I2C1_VOUT1: JP17.2, M25.P$3, M29.P$3, R77.2, R80.2
IMU_FSYNC: TP31.P$1, U3.P$64, U6.12
IMU_FSYNC1: TP67.P$1, U2.P$64, U14.12
IMU_FSYNC_VDDIO: U5.11, U6.9
IMU_FSYNC_VDDIO1: U11.11, U14.9
IMU_INT: TP30.P$1, U3.P$63, U6.11
IMU_INT1: TP66.P$1, U2.P$63, U14.11
IMU_INT_VDDIO: U5.12, U6.10
IMU_INT_VDDIO1: U11.12, U14.10
IMU_RESV1: JP10.1, U5.1
IMU_RESV2: JP12.1, U11.1
IMU_VDDIO: C13.1, JP9.2, JP10.2, TP17.P$1, U5.8, U6.5, U6.6
IMU_VDDIO1: C29.1, JP8.2, JP12.2, TP63.P$1, U11.8, U14.5, U14.6
LTS: Q19.2, R58.1, TP70.P$1, U3.P$82
LTS1: Q36.2, R102.1, TP94.P$1, U2.P$82
LTS_12V: M19.P$2, M20.P$2, Q19.3, R62.1
LTS_12V1: M35.P$2, M36.P$2, Q36.3, R103.1
unnamed: C23.1, U2.P$73
unnamed: J2.SHIELD, J2.SHIELD2, J2.SHIELD3, J2.SHIELD4, J2.SHIELD5, J2.SHIELD6, J2.SHIELD7, J2.SHIELD8, J2.SHIELD9, J2.SHIELD10, R10.2
unnamed: C11.1, U3.P$73
unnamed: J1.SHIELD, J1.SHIELD2, J1.SHIELD3, J1.SHIELD4, J1.SHIELD5, J1.SHIELD6, J1.SHIELD7, J1.SHIELD8, J1.SHIELD9, J1.SHIELD10, R1.2
unnamed: C10.1, U3.P$48
unnamed: C22.1, U2.P$48
unnamed: Q1.5, R3.1
unnamed: Q1.2, R4.1
unnamed: Q11.5, R2.1
unnamed: Q11.2, R5.1
unnamed: C28.1, U11.10
unnamed: J5.2, R86.1
unnamed: C15.1, U5.10
unnamed: J5.4, R85.1
unnamed: D8.C, R55.2
unnamed: J3.2, R13.1
unnamed: J3.4, R14.1
unnamed: D15.C, R95.2
unnamed: D6.C, R53.2
unnamed: D1.C, R7.2
unnamed: D3.C, R8.2
unnamed: D12.C, R69.2
unnamed: D14.C, R94.2
unnamed: D13.C, R96.2
unnamed: D5.C, R12.2
unnamed: D4.C, R11.2
unnamed: D9.C, R93.2
unnamed: D7.C, R92.2
unnamed: J6.SHIELD, J6.SHIELD2, J6.SHIELD3, J6.SHIELD4, J6.SHIELD5, J6.SHIELD6, J6.SHIELD7, J6.SHIELD8, J6.SHIELD9, J6.SHIELD10, R110.2
unnamed: D19.C, R111.2
unnamed: D20.C, R112.2
unnamed: J4.SHIELD, J4.SHIELD2, J4.SHIELD3, J4.SHIELD4, J4.SHIELD5, J4.SHIELD6, J4.SHIELD7, J4.SHIELD8, J4.SHIELD9, J4.SHIELD10, R113.2
PH0: C7.2, U3.P$12, Y1.3
PH1: C8.2, U3.P$13, Y1.1
PH2: C21.2, U2.P$13, Y2.1
PH3: C19.2, U2.P$12, Y2.3
QSPI_BK1_IO0: Q9.2, R32.1, TP37.P$1, U3.P$58
QSPI_BK1_IO5: Q28.2, R75.1, TP90.P$1, U2.P$58
QSPI_BK2_IO0: U3.P$37, U9.5
QSPI_BK2_IO1: U3.P$38, U9.2
QSPI_BK2_IO2: U3.P$39, U9.3
QSPI_BK2_IO3: U3.P$40, U9.7
QSPI_BK2_IO4: U2.P$37, U16.5
QSPI_BK2_IO5: U2.P$38, U16.2
QSPI_BK2_IO6: U2.P$39, U16.3
QSPI_BK2_IO7: U2.P$40, U16.7
QSPI_BK2_NCS: U3.P$79, U9.1
QSPI_BK2_NCS1: U2.P$79, U16.1
QSPI_SCLK: Q5.2, R24.1, TP45.P$1, U3.P$36, U9.6
QSPI_SCLK1: Q27.2, R73.1, TP92.P$1, U2.P$36, U16.6
REV: Q21.2, R60.1, TP72.P$1, U3.P$84
REV1: Q38.2, R106.1, TP96.P$1, U2.P$84
REV_12V: M19.P$4, M20.P$4, Q21.3, R64.1
REV_12V1: M35.P$4, M36.P$4, Q38.3, R107.1
RTS: Q20.2, R59.1, TP71.P$1, U3.P$83
RTS1: Q37.2, R104.1, TP95.P$1, U2.P$83
RTS_12V: M19.P$3, M20.P$3, Q20.3, R63.1
RTS_12V1: M35.P$3, M36.P$3, Q37.3, R105.1
SD_CD: M21.CD_SW1, R66.2, TP25.P$1, U3.P$15
SD_CD1: M12.CD_SW1, R15.2, TP64.P$1, U2.P$15
SPI1_MISO: M21.P$7, TP21.P$1, U3.P$30, U6.13
SPI1_MISO1: M12.P$7, TP56.P$1, U2.P$30, U14.13
SPI1_MISO_VDDIO: U5.9, U6.8
SPI1_MISO_VDDIO1: U11.9, U14.8
SPI1_MOSI: M21.P$3, TP20.P$1, U3.P$88, U6.18
SPI1_MOSI1: M12.P$3, TP55.P$1, U2.P$88, U14.18
SPI1_MOSI_VDDIO: U5.24, U6.3
SPI1_MOSI_VDDIO1: U11.24, U14.3
SPI1_SCLK: M21.P$5, TP22.P$1, U3.P$89, U6.19
SPI1_SCLK1: M12.P$5, TP59.P$1, U2.P$89, U14.19
SPI1_SCLK_VDDIO: U5.23, U6.2
SPI1_SCLK_VDDIO1: U11.23, U14.2
SPI2_MOSI: Q6.2, R29.1, TP34.P$1, U3.P$16
SPI2_MOSI1: Q15.2, R44.1, TP81.P$1, U2.P$16
SPI2_SCLK: Q2.2, R21.1, TP42.P$1, U3.P$52
SPI2_SCLK1: Q13.2, R40.1, TP83.P$1, U2.P$52
SPI3_MOSI: Q7.2, R30.1, TP35.P$1, U3.P$87
SPI3_MOSI1: Q24.2, R52.1, TP84.P$1, U2.P$87
SPI3_SCLK: Q3.2, R22.1, TP43.P$1, U3.P$78
SPI3_SCLK1: Q17.2, R48.1, TP86.P$1, U2.P$78
SPI4_MOSI: Q8.2, R31.1, TP36.P$1, U3.P$5
SPI4_MOSI1: Q26.2, R71.1, TP87.P$1, U2.P$5
SPI4_SCLK: Q4.2, R23.1, TP44.P$1, U3.P$42
SPI4_SCLK1: Q25.2, R56.1, TP89.P$1, U2.P$42
SPI6_MISO: TP8.P$1, U1.31, U3.P$90
SPI6_MISO1: TP26.P$1, U2.P$90, U10.31
SPI6_MOSI: TP7.P$1, U1.37, U3.P$31
SPI6_MOSI1: TP19.P$1, U2.P$31, U10.37
SPI6_SCLK: TP9.P$1, U1.30, U3.P$29
SPI6_SCLK1: TP27.P$1, U2.P$29, U10.30
STM_!RESET: C12.2, J3.10, R19.1, S4.1, S4.2, TP62.P$1, U3.P$14
STM_!RESET1: C33.2, J5.10, R89.1, S6.1, S6.2, TP101.P$1, U2.P$14
STM_USB_DM: J2.D-, U3.P$70
STM_USB_DM1: J4.D-, U2.P$70
STM_USB_DP: J2.D+, U3.P$71
STM_USB_DP1: J4.D+, U2.P$71
SWCLK: R14.2, R17.1, TP68.P$1, U3.P$76
SWCLK1: R85.2, R87.1, TP102.P$1, U2.P$76
SWDIO: R13.2, R18.1, TP78.P$1, U3.P$72
SWDIO1: R86.2, R88.1, TP103.P$1, U2.P$72
UART4_RX: U1.28, U3.P$23
UART4_RX1: U2.P$23, U10.28
UART4_TX: U1.27, U3.P$22
UART4_TX1: U2.P$22, U10.27
ULED1: R11.1, U3.P$7
ULED2: R12.1, U3.P$8
ULED3: R93.1, U2.P$8
ULED4: R92.1, U2.P$7
US1: M1.P$3, M2.P$3, R20.2, S5.1, S5.2, U3.P$85
US2: M1.P$1, M2.P$1, R16.2, S3.1, S3.2, U3.P$86
US3: M37.P$1, M38.P$1, R90.2, S7.1, S7.2, U2.P$86
US4: M37.P$3, M38.P$3, R91.2, S8.1, S8.2, U2.P$85
USART1_RX: Q16.2, R47.1, R55.1, TP58.P$1, U3.P$54
USART1_RX1: Q32.2, R83.1, R95.1, TP100.P$1, U2.P$54
USART1_RX_VOUT: M13.P$1, M17.P$1, Q16.3, R51.1
USART1_RX_VOUT1: M26.P$1, M30.P$1, Q32.3, R84.1
USART1_TX: Q12.2, R39.1, R53.1, TP57.P$1, U3.P$53
USART1_TX1: Q31.2, R82.1, R94.1, TP99.P$1, U2.P$53
USART1_TX_VOUT: M13.P$2, M17.P$2, Q12.3, R43.1
USART1_TX_VOUT1: M26.P$2, M30.P$2, Q31.3, R81.1
USART1_VOUT: JP7.2, M13.P$3, M17.P$3, R43.2, R51.2
USART1_VOUT1: JP18.2, M26.P$3, M30.P$3, R81.2, R84.2
USB_OTG_FS_ID: J2.ID, U3.P$69
USB_OTG_FS_ID1: J4.ID, U2.P$69
VOVP: D10.C, F1.2, JP11.2, Q23.3, TP48.P$1
VOVP1: D16.C, F2.2, JP19.2, Q34.3, TP75.P$1
VRAW: M22.P$2, M23.P$3, Q22.3
VRAW1: M27.P$3, M28.P$2, Q33.3
VRPP: F1.1, JP11.1, Q22.2, TP47.P$1
VRPP1: F2.1, JP19.1, Q33.2, TP74.P$1
V_USB: D11.A, J1.VBUS, J2.VBUS, Q23.1, R68.2, TP49.P$1, U3.P$68
V_USB1: D17.A, J4.VBUS, J6.VBUS, Q34.1, R97.2, TP76.P$1, U2.P$68
