oclyke-retired/Doppler_LED_Controller/Software/Embedded/Atollic/CDC_USB/CDC_USB.ioc

Mcu.UserName=STM32F765VGTx
PA0/WKUP.Signal=UART4_TX
PA1.Signal=UART4_RX
PA11.Signal=USB_OTG_FS_DM
PA12.Signal=USB_OTG_FS_DP
PA13.Signal=SYS_JTMS-SWDIO
PA14.Signal=SYS_JTCK-SWCLK
PA5.Signal=SPI6_SCK
PA6.Signal=SPI1_MISO
PA7.Signal=SPI6_MOSI
PA8.Signal=USB_OTG_FS_SOF
PA9.Signal=USB_OTG_FS_VBUS
PB10.Signal=I2C2_SCL
PB11.Signal=I2C2_SDA
PB12.Signal=UART5_RX
PB13.Signal=SPI2_SCK
PB14.Signal=USART1_TX
PB15.Signal=USART1_RX
PB2.Signal=QUADSPI_CLK
PB3.Signal=SPI1_SCK
PB4.Signal=SPI6_MISO
PB6.Signal=QUADSPI_BK1_NCS
PB7.Signal=I2C1_SDA
PB8.Signal=I2C1_SCL
PC0.GPIO_Label=SD_CD
PC0.Signal=GPIO_Input
PC1.Signal=SPI2_MOSI
PC10.Signal=SPI3_SCK
PC11.Signal=QUADSPI_BK2_NCS
PC12.Signal=UART5_TX
PC13.GPIO_Label=ULED1
PC13.Signal=GPIO_Output
PC14/OSC32_IN.GPIO_Label=ULED2
PC14/OSC32_IN.Signal=GPIO_Output
PC15/OSC32_OUT.GPIO_Label=ESP_DRDY
PC15/OSC32_OUT.Signal=GPIO_Input
PC6.GPIO_Label=IMU_INT
PC6.Signal=GPIO_Input
PC7.GPIO_Label=IMU_FSYNC
PC7.Signal=GPIO_Input
PD0.GPIO_Label=BRK
PD0.Signal=GPIO_Input
PD1.GPIO_Label=LTS
PD1.Signal=GPIO_Input
PD11.Signal=QUADSPI_BK1_IO0
PD12.Signal=QUADSPI_BK1_IO1
PD13.Signal=QUADSPI_BK1_IO3
PD2.GPIO_Label=RTS
PD2.Signal=GPIO_Input
PD3.GPIO_Label=REV
PD3.Signal=GPIO_Input
PD4.GPIO_Label=US1
PD4.Signal=GPIO_Input
PD5.GPIO_Label=US2
PD5.Signal=GPIO_Input
PD6.Signal=SPI3_MOSI
PD7.Signal=SPI1_MOSI
PE0.Signal=UART8_RX
PE1.Signal=UART8_TX
PE10.Signal=QUADSPI_BK2_IO3
PE12.Signal=SPI4_SCK
PE2.Signal=QUADSPI_BK1_IO2
PE3.GPIO_Label=CS_SD
PE3.Signal=GPIO_Output
PE4.GPIO_Label=CS_IMU
PE4.Signal=GPIO_Output
PE5.GPIO_Label=CS_ESP
PE5.Signal=GPIO_Output
PE6.Signal=SPI4_MOSI
PE7.Signal=QUADSPI_BK2_IO0
PE8.Signal=QUADSPI_BK2_IO1
PE9.Signal=QUADSPI_BK2_IO2
PH0/OSC_IN.Signal=RCC_OSC_IN
PH1/OSC_OUT.Signal=RCC_OSC_OUT
