oclyke-retired/Doppler_LED_Controller/Software/Embedded/Ports/print_setup.h

#ifndef __PRINT_SETUP_H_
#define __PRINT_SETUP_H_

// Defines to use in print.h
#define PRINT_ERR 1U
#define PRINT_FMT 1U // 1: allow formatted printing, 0: don't
#define PRINT_DYN 1U // 1: allow dynamic memory allocation, 0: disallow
#define PRINT_DYN_MAX 512U // Defines a maximum size of a dynamically allocated buffer.



#endif /* __PRINT_SETUP_H_ */
