oclyke-retired/Doppler_LED_Controller/(commit log)

2018-11-28 Initial Commit
    In this commit all relevant files from the MT/AES project were copied into this repo.
    [Doppler_LED_Controller-Panel.GBL, Doppler_LED_Controller-Panel.GBO, Doppler_LED_Controller-Panel.GBP, Doppler_LED_Controller-Panel.GBS, Doppler_LED_Controller-Panel.GKO, Doppler_LED_Controller-Panel.GTL, Doppler_LED_Controller-Panel.GTO, Doppler_LED_Controller-Panel.GTP]
2018-12-01 Fixed clock and NVIC in default peripheral configuration
    [DopplerPeriConf.ioc]
2018-12-16 Add SPI Flash Library and STM32F7 Quadspi port
2018-12-16 Add STM32F7 port for SPIDS
2018-12-16 Add USB Device Configuration
2018-12-16 Add ESP Relay project
2018-12-24 Add print header
2018-12-24 Add printing ports for stm32f7
